MsegalLeeds/drone-project/hardware/README.md

# Hardware

Use this area for the physical engineering work.

Suggested structure:

```text
cad/             CAD models and exported design files
electronics/     Schematics, PCB work and wiring
manufacturing/   Manufacturing notes and processes
drawings/        Engineering drawings
bom/             Bills of materials
```

Keep final/relevant design files under version control where practical.
