MsegalLeeds/drone-project/docs/requirements.md

# System Requirements

These are the initial requirements to be completed by the team. Do not invent final values; agree and justify them using calculations, testing and project constraints.

| ID | Requirement | Target | Verification |
|---|---|---|---|
| REQ-001 | Maximum take-off mass | TBD | Weigh aircraft |
| REQ-002 | Payload mass | TBD | Payload test |
| REQ-003 | Flight time | TBD | Flight test |
| REQ-004 | Maximum speed | TBD | Flight test |
| REQ-005 | Stable hover | TBD | Flight test |
| REQ-006 | Operating environment | TBD | Inspection / test |
| REQ-007 | Safe shutdown / failsafe behaviour | TBD | Controlled test |

## Constraints

- University facilities and supervision requirements.
- Available budget and component lead times.
- Manufacturing capability.
- Battery and propulsion limitations.
- Software and electronics development time.
- Applicable aviation and university rules.

Each requirement should have a measurable target and verification method.
