MsegalLeeds/drone-project/hardware/wiring/bench-and-buzzer.png

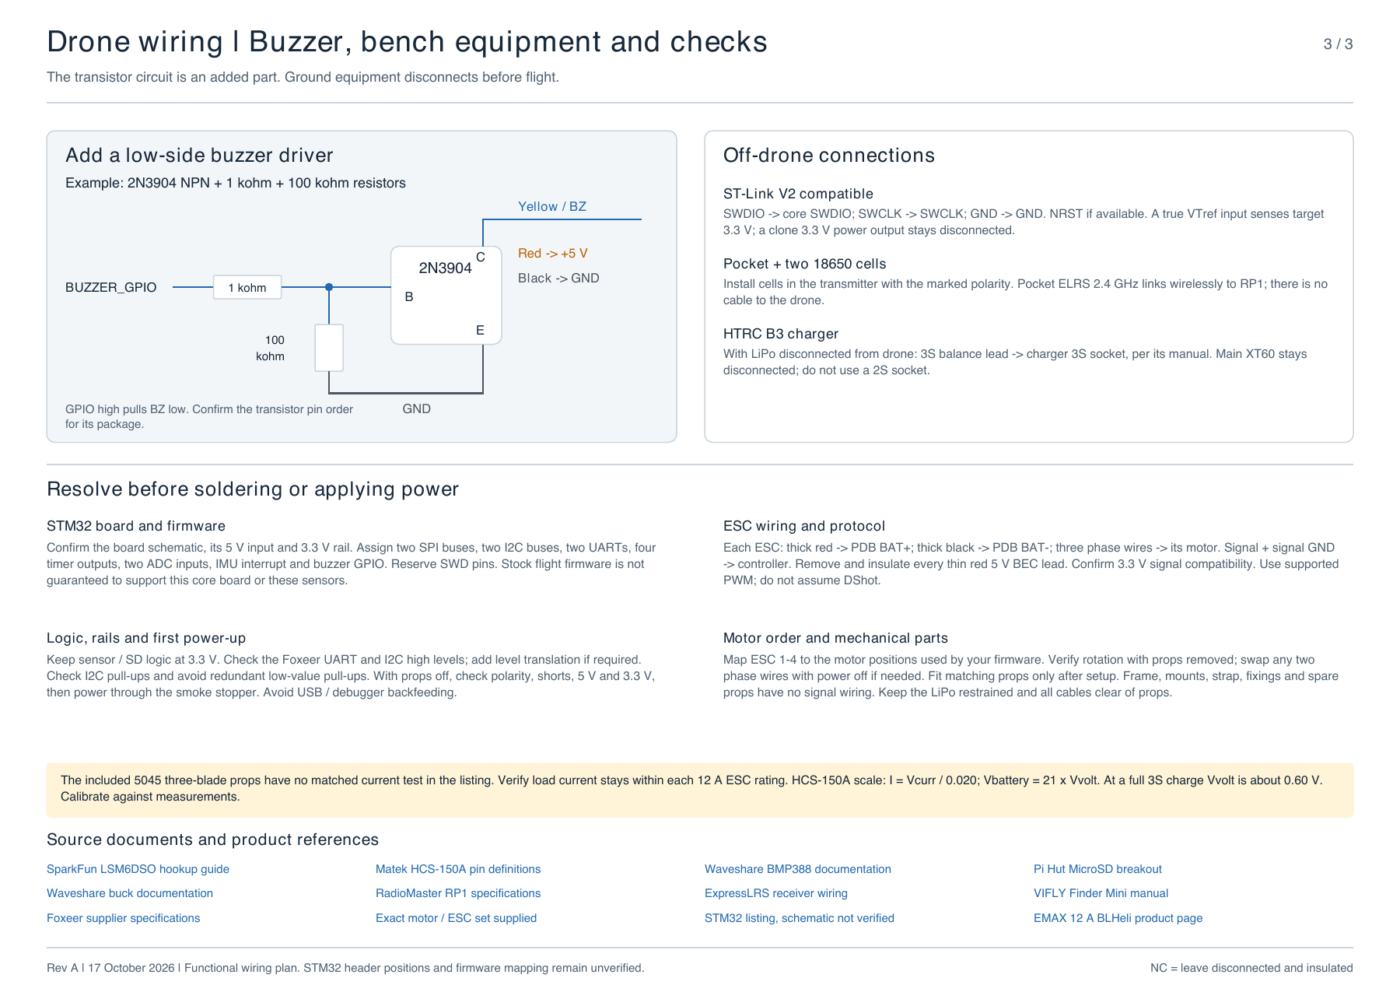
hardware/wiring/bench-and-buzzer.png
