MsegalLeeds/drone-project/hardware/wiring/signal-wiring.png

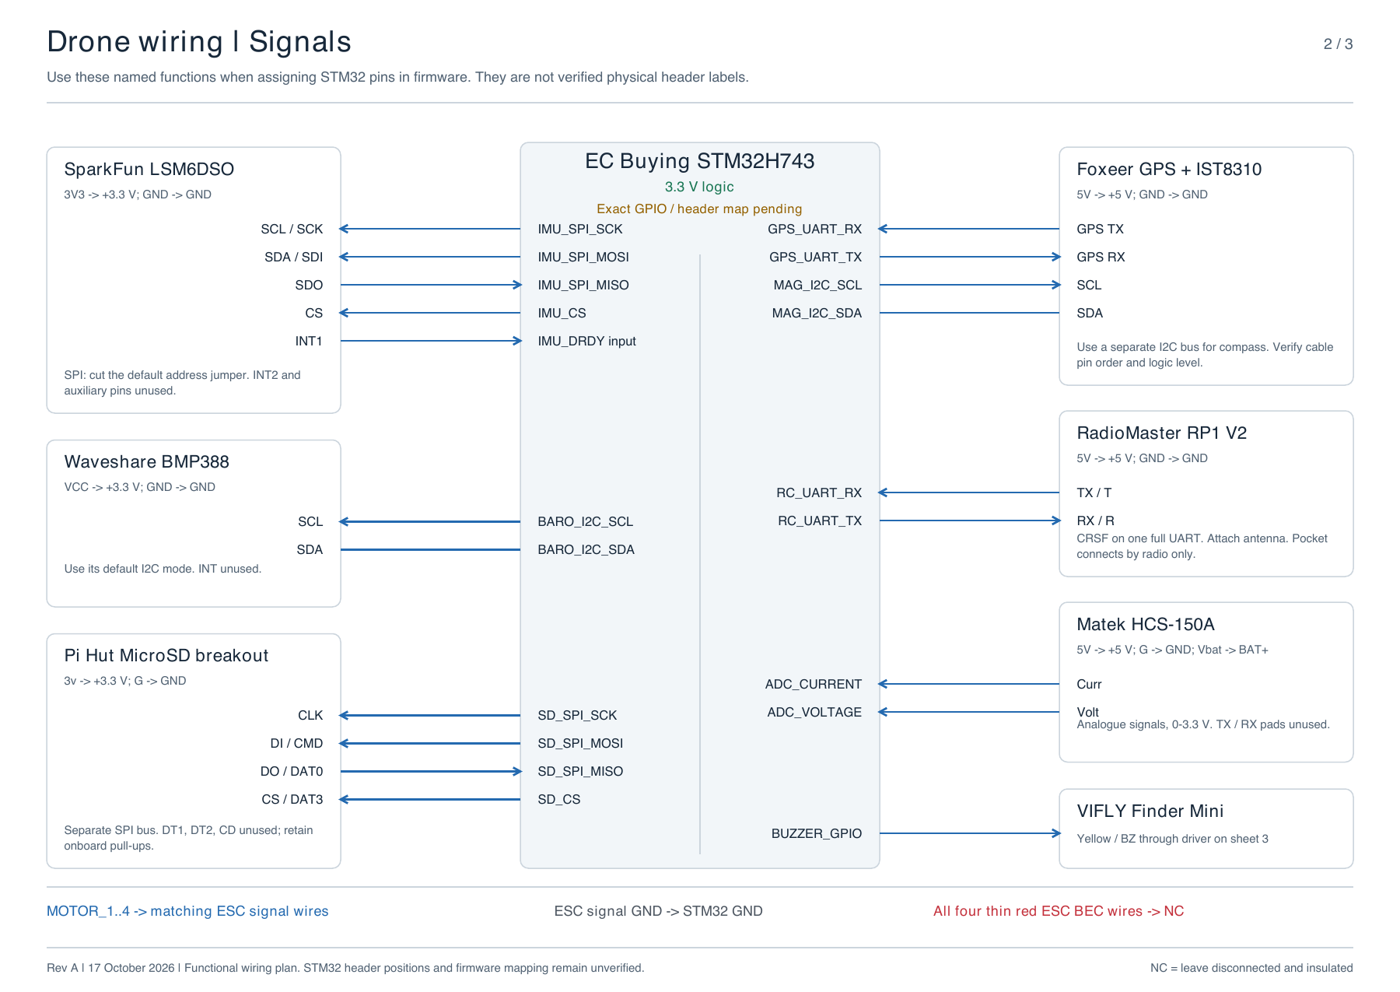
hardware/wiring/signal-wiring.png
