MsegalLeeds/drone-project/experiments/attitude-simulation/attitude.csv

time | true_roll | estimated_roll | target_roll | control | true_pitch | estimated_pitch | target_pitch | pitch_control | true_yaw | true_yaw_rate | target_yaw_rate | yaw_control
0.00 | 19.995001 | 20.000000 | 0.000000 | -100.000000 | -14.995000 | -14.999999 | 0.000000 | 100.000000 | 0.000000 | 0.000000 | 0.000000 | 0.000000
0.01 | 19.983826 | 19.995001 | 0.000000 | -98.975174 | -14.986325 | -14.994999 | 0.000000 | 73.974968 | 0.000000 | 0.000000 | 0.000000 | 0.000000
0.02 | 19.966595 | 19.983826 | 0.000000 | -97.684097 | -14.974005 | -14.986324 | 0.000000 | 73.196701 | 0.000000 | 0.000000 | 0.000000 | 0.000000
0.03 | 19.943422 | 19.966595 | 0.000000 | -96.386780 | -14.958068 | -14.974004 | 0.000000 | 72.405914 | 0.000000 | 0.000000 | 0.000000 | 0.000000
0.04 | 19.914423 | 19.943422 | 0.000000 | -95.082634 | -14.938544 | -14.958067 | 0.000000 | 71.602966 | 0.000000 | 0.000000 | 0.000000 | 0.000000
0.05 | 19.879709 | 19.914423 | 0.000000 | -93.772247 | -14.915462 | -14.938543 | 0.000000 | 70.787994 | 0.000000 | 0.000000 | 0.000000 | 0.000000
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
