MsegalLeeds/drone-project/experiments/stm32-usb/mac.csv

level | 0.00000 | 0.00000 | 0.50000 | 0.50000 | 0.50000 | 0.50000
right | 10.00000 | 0.00000 | 0.25000 | 0.75000 | 0.75000 | 0.25000
returned | 0.00000 | 0.00000 | 0.50000 | 0.50000 | 0.50000 | 0.50000
fault_mask | 255
