MsegalLeeds/drone-project/experiments/attitude-simulation/attitude.png

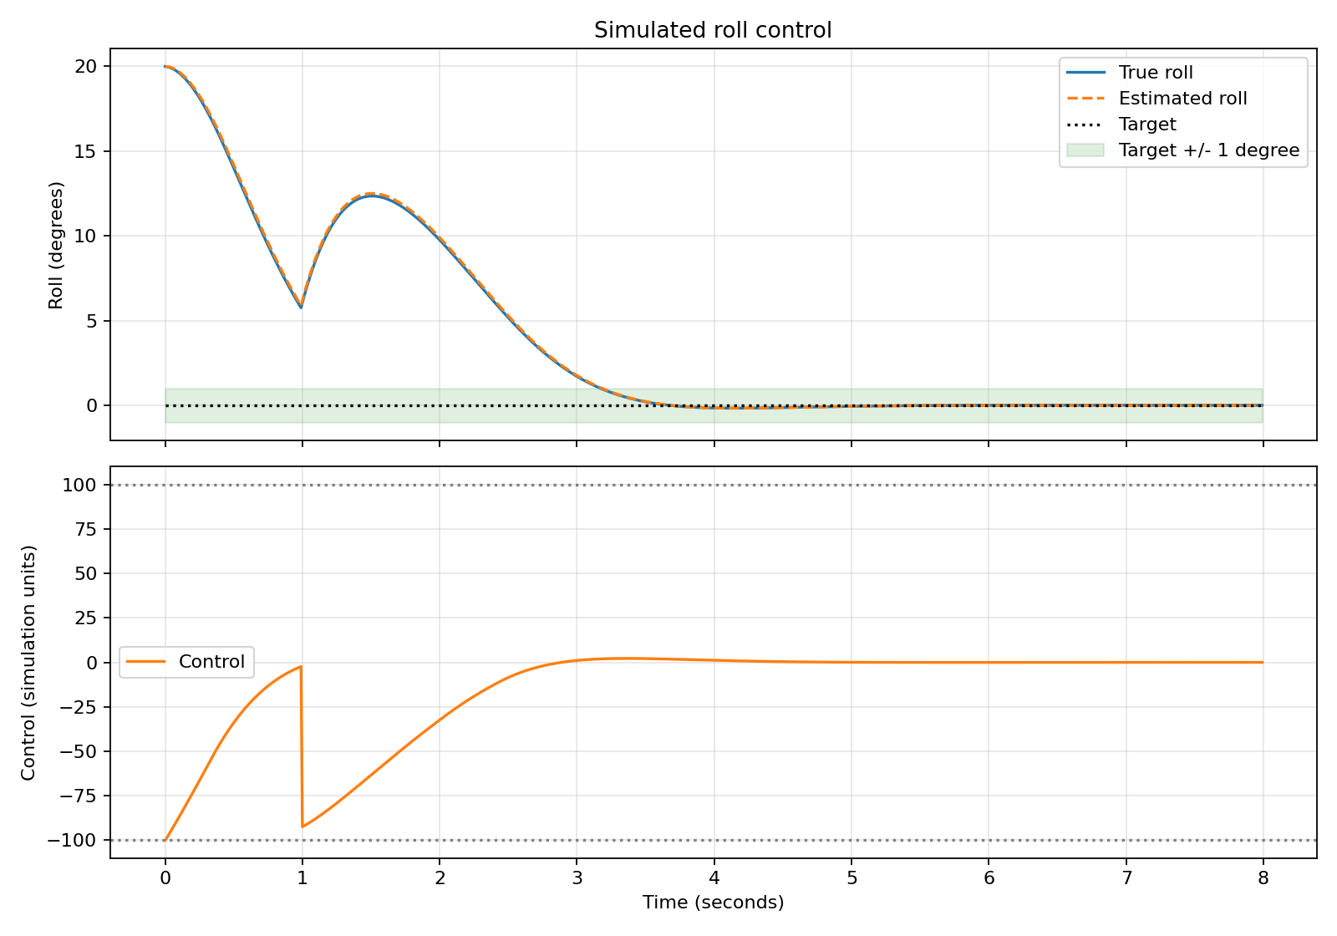
experiments/attitude-simulation/attitude.png
