MsegalLeeds/drone-project/experiments/attitude-simulation/attitude_yaw.png

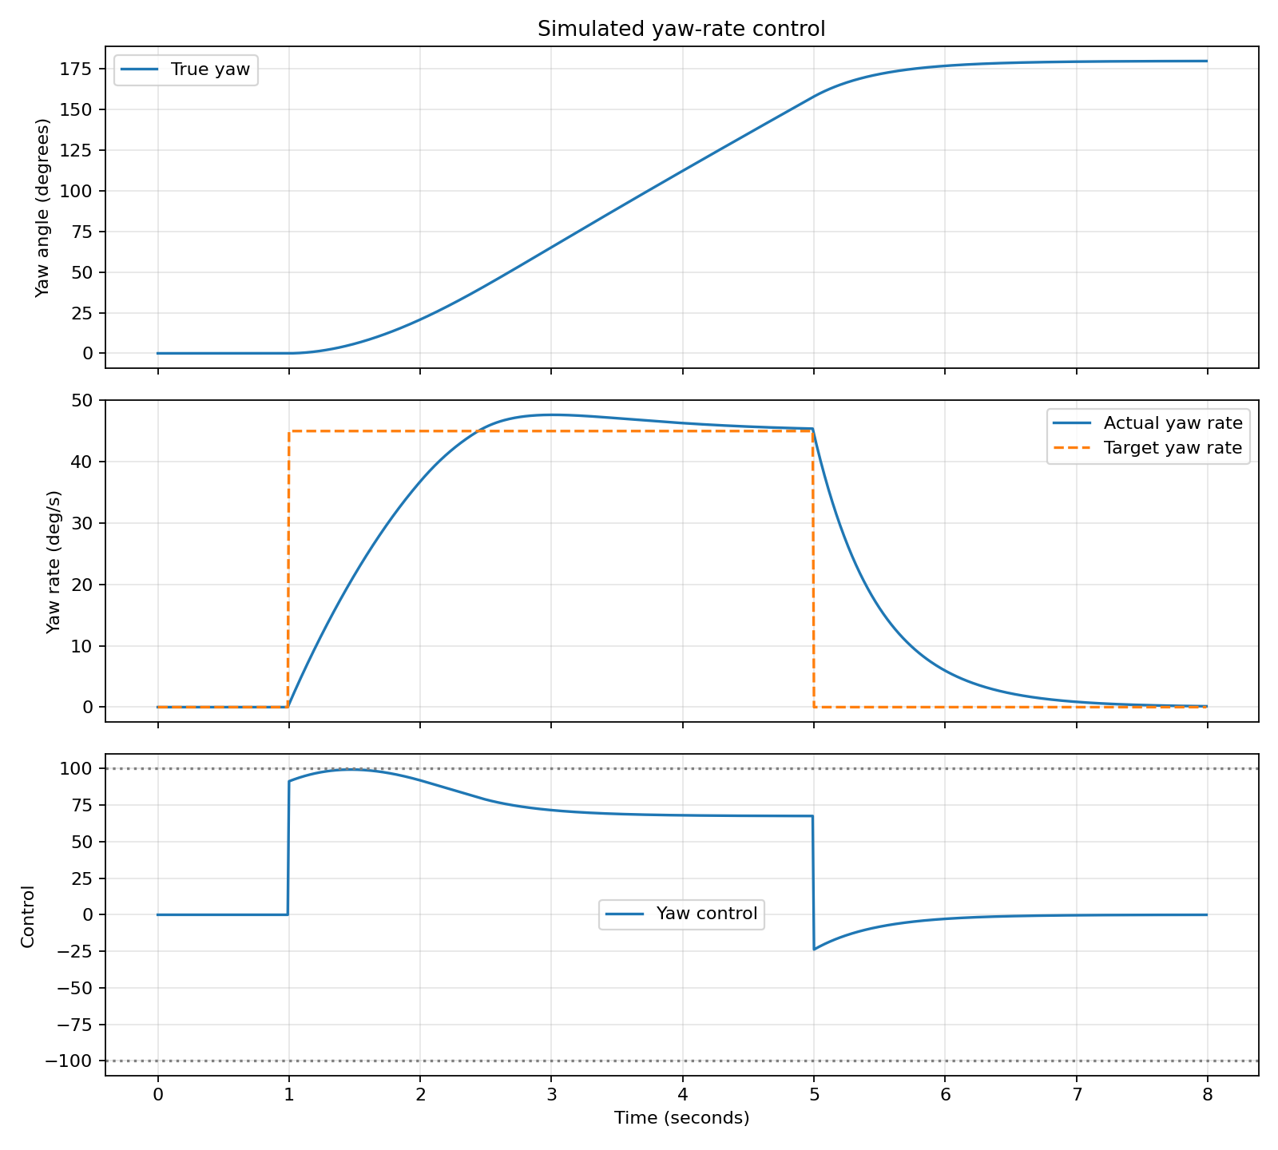
experiments/attitude-simulation/attitude_yaw.png
