MsegalLeeds/drone-project/software/stm32/usb-bench/tusb_config.h

#pragma once
#define CFG_TUSB_MCU OPT_MCU_STM32H7
#define CFG_TUSB_OS OPT_OS_NONE
#define CFG_TUSB_RHPORT0_MODE (OPT_MODE_DEVICE | OPT_MODE_FULL_SPEED)
#define CFG_TUD_CDC 1
#define CFG_TUD_ENDPOINT0_SIZE 64
#define CFG_TUD_CDC_RX_BUFSIZE 64
#define CFG_TUD_CDC_TX_BUFSIZE 512
