MsegalLeeds/drone-project/software/flight-controller/tests/test_imu.c

#include "imu.h"

#include <assert.h>
#include <math.h>
#include <stdio.h>

#define EPSILON 0.01f

static int nearly_equal(float a, float b)
{
    return fabsf(a - b) < EPSILON;
}

static void test_level_drone(void)
{
    ImuSample sample = imu_simulate(0.0f, 0.0f);

    assert(nearly_equal(sample.gyro_x, 0.0f));
    assert(nearly_equal(sample.accel_y, 0.0f));
    assert(nearly_equal(sample.accel_z, 9.81f));
}

static void test_roll_angle(void)
{
    ImuSample sample = imu_simulate(30.0f, 0.0f);

    assert(nearly_equal(sample.accel_y, 4.905f));
    assert(nearly_equal(sample.accel_z, 8.495f));
}

static void test_roll_rate(void)
{
    ImuSample sample = imu_simulate(0.0f, 45.0f);

    assert(nearly_equal(sample.gyro_x, 45.0f));
}

static void test_gyro_calibration(float bias)
{
    ImuSample samples[] = {
        {.gyro_x = bias - 0.2f},
        {.gyro_x = bias + 0.2f},
        {.gyro_x = bias - 0.1f},
        {.gyro_x = bias + 0.1f}
    };

    float offset = imu_calibrate_gyro_x(samples, 4);
    assert(nearly_equal(offset, bias));

    /* Subtract the bias without removing genuine rotation. */
    ImuSample moving = imu_simulate(0.0f, 30.0f);
    moving.gyro_x += bias;
    moving.gyro_x -= offset;

    assert(nearly_equal(moving.gyro_x, 30.0f));
}

static void test_pitch_angle(void)
{
    ImuSample sample =
        imu_simulate_attitude(
            0.0f,
            30.0f,
            0.0f,
            0.0f
        );

    assert(
        nearly_equal(
            sample.accel_x,
            -4.905f
        )
    );

    assert(
        nearly_equal(
            sample.accel_y,
            0.0f
        )
    );

    assert(
        nearly_equal(
            sample.accel_z,
            8.495f
        )
    );
}

static void test_pitch_rate(void)
{
    ImuSample sample =
        imu_simulate_attitude(
            0.0f,
            0.0f,
            0.0f,
            45.0f
        );

    assert(
        nearly_equal(
            sample.gyro_y,
            45.0f
        )
    );
}

static void test_gyro_y_calibration(void)
{
    ImuSample samples[] = {
        {.gyro_y = 1.8f},
        {.gyro_y = 2.2f},
        {.gyro_y = 1.9f},
        {.gyro_y = 2.1f}
    };

    float offset =
        imu_calibrate_gyro_y(
            samples,
            4
        );

    assert(
        nearly_equal(
            offset,
            2.0f
        )
    );
}

int main(void)
{
    test_level_drone();
    test_roll_angle();
    test_roll_rate();
    test_gyro_calibration(0.0f);
    test_gyro_calibration(1.0f);
    test_gyro_calibration(-1.0f);
    test_pitch_angle();
    test_pitch_rate();
    test_gyro_y_calibration();

    printf("IMU tests passed\n");
    return 0;
}
