MsegalLeeds/drone-project/(commit log)

2026-10-12 feat: add flight-controller simulation with unified IMU
    Establish the CMake-based roll simulation, PID controller, attitude estimator and four test suites. Use one simulated IMU contract with documented units and cover negative roll and angular rate.
2026-10-12 test: verify roll recovery with disturbances and gyro bias
2026-10-12 Roll response with a 45°/s disturbance and +1°/s gyro bias
2026-10-12 feat: add quad-x motor mixer
2026-10-12 feat: drive roll simulation from motor outputs
2026-10-12 feat: integrate motor mixer into roll control loop
2026-10-12 git add software/flight-controller git commit -m "feat: add vertical thrust and altitude simulation"
2026-10-12 Enhance flight controller simulation with motor dynamics
    This update introduces a Quad-X motor mixer for simulating motor-driven dynamics in the flight controller. It includes detailed explanations of the motor outputs, roll torque calculations, vertical dynamics, and limitations of the current simulation model.
2026-10-12 Update development stages to reflect progress
2026-10-14 feat: add pitch attitude control
2026-10-14 feat: add yaw rate control
2026-11-09 feat: bring STM32 bench, wiring plans and CLion build targets into the project
